ariffizmdn/ArmGuard/images/Circuit Design.png

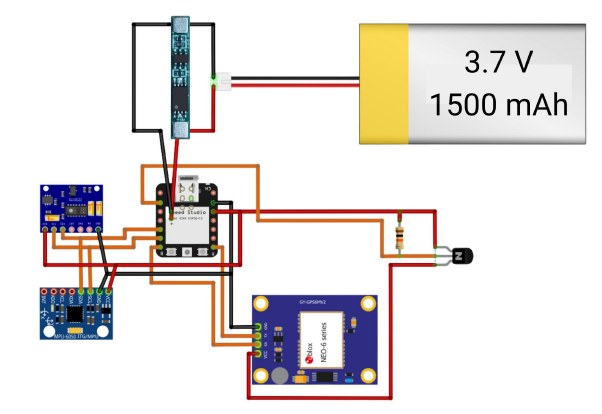
images/Circuit Design.png
