ariffizmdn/ArmGuard/images/Internal Hardware.png

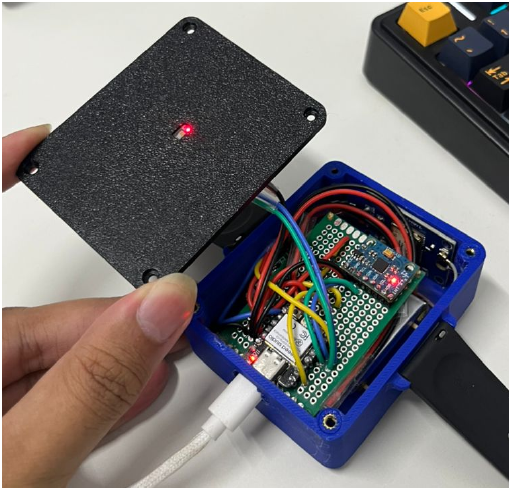
images/Internal Hardware.png
