ariffizmdn/ArmGuard/images/Software Flowchart.png

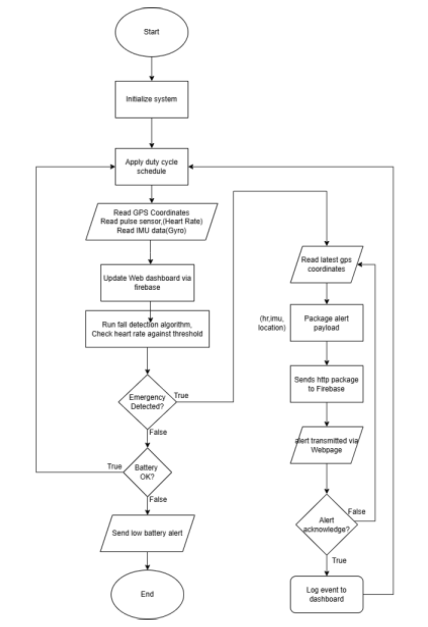
images/Software Flowchart.png
