ariffizmdn/ArmGuard/images/Telegram notification.png

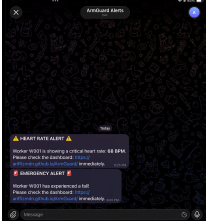
images/Telegram notification.png
