ariffizmdn/ArmGuard/images/Webpage UI.png

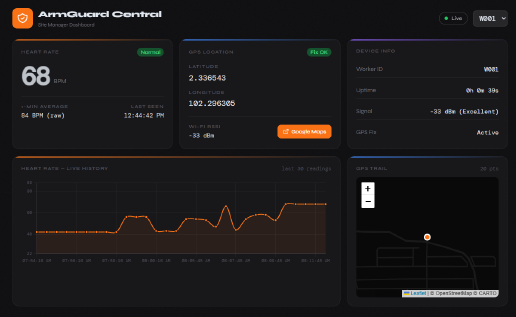
images/Webpage UI.png
