ariffizmdn/ArmGuard/ArmGuard_BOM.xlsx

Sheet: Sheet1
Component List
Bil | Name | Component | Datasheet | Quantity | Price Per Quantity(RM) | Total Price(RM)
1 | NFC | PN 532 |  | 2 | 17.1 | 34.2
2 | Microcontroller | Seeed Studio XIAO ESP32C6 |  | 2 | 39.95 | 79.9
3 | Gyro & Accelerometer | GY-521 |  | 2 | 8.95 | 17.9
4 | GPS Module | NEO-6M GPS |  | 2 | 15.95 | 31.9
 | Pulse Sensor Module Arduino | Pulse Sensor |  | 2 | 12.95 | 25.9
5 | Pulse Sensor Module | MAX30102 |  | 1 | 5.99 | 5.99
6 | Pulse Sensor Module Tambahan | MAX30102 |  | 1 | 9.9 | 9.9
7 | Buck Converter | Mini 360 DC-DC |  | 3 | 1.94 | 5.82
8 | Super capacitor 5.5v | 5.5v 0.22F |  | 2 | 2.81 | 5.62
 | LiPo Rechargable Battery | 3.7 1500mAh |  | 1 | 30.98 | 30.98
 | BMS | 1 Cell 2A |  | 1 | 1.39 | 1.39
9 | MOSFET | SI2301 |  | 1 | 2 | 2
10 | 3D Print | Top Shell + Bottom Plate |  | 2 | 18.725 | 37.45
11 | Electrical Jumper Wire | AWG26 |  | 1 | 24.9 | 24.9
12 | Perfboard | 4x6cm |  | 2 | 4.345 | 8.69
 |  |  | Total | 25 | RM 197.88 | RM 322.54

Sheet: Sheet2
79.9
17.9
31.9
5.99
9.9
30.98
2.78
2
37.45
24.9
8.69
252.39
